CMPE2750/davidm_embedded/CMPE2750.kicad_pcb

## KiCad design CMPE2750.kicad_pcb (2024-11-19)

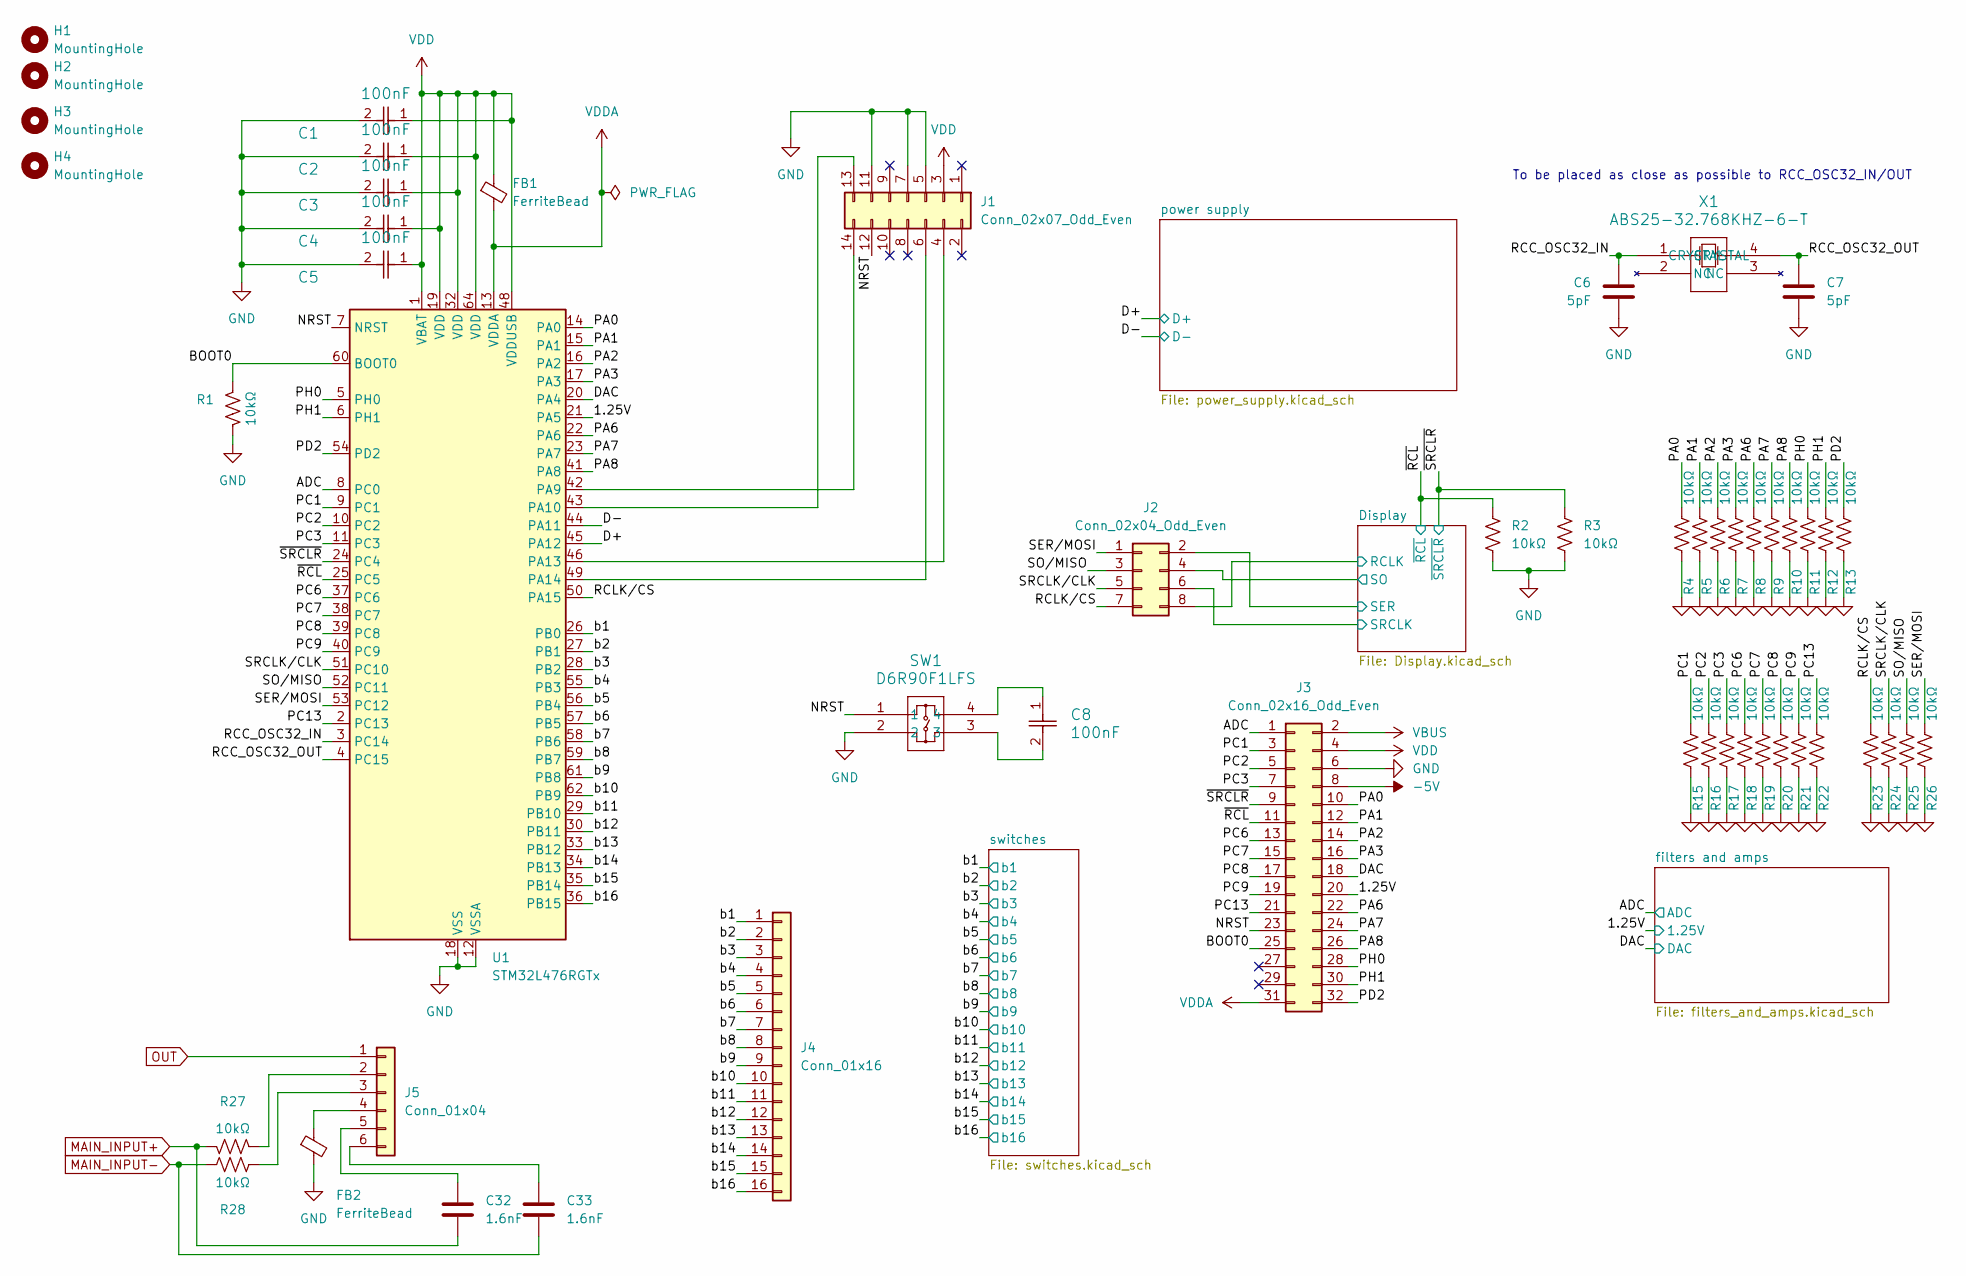
[picture p1: schematic CMPE2750.kicad_sch]

Parts:
C1, C2, C3, C4, C5, C8: 100nF; C_0402_1005Metric
C6, C7: 5pF; C_0402_1005Metric
C32, C33: 1.6nF; C_0805_2012Metric
FB1, FB2: FerriteBead; L_0603_1608Metric
H1, H2, H3, H4: MountingHole; MountingHole_3.2mm_M3
J1: Conn_02x07_Odd_Even; CONN_FTSH-107-01-F-DV-K-P-TR_SAI
J2: Conn_02x04_Odd_Even; PinHeader_2x04_P2.54mm_Vertical
J3: Conn_02x16_Odd_Even; PinHeader_2x16_P2.54mm_Vertical
J4: Conn_01x16; PinHeader_1x16_P2.54mm_Vertical
J5: Conn_01x04; PinHeader_1x06_P2.54mm_Vertical
R1, R2, R3, R4, R5, R6, R7, R8, R9, R10, R11, R12, R13, R15, R16, R17, R18, R19, R20, R21, R22, R23, R24, R25, R26, R27, R28: 10kΩ; R_0402_1005Metric
SW1: D6R90F1LFS; D6R_CNK
U1: STM32L476RGTx; LQFP-64_10x10mm_P0.5mm
X1: ABS25-32.768KHZ-6-T; X_ABS25_ABR

Connections:
-5V: J3.8; also elsewhere on the board
/1.25V: J3.20, U1.21 (PA5); also elsewhere on the board
/ADC: J3.1, U1.8 (PC0); also elsewhere on the board
/BOOT0: J3.25, R1.1, U1.60 (BOOT0)
/D+: U1.45 (PA12); also elsewhere on the board
/D-: U1.44 (PA11); also elsewhere on the board
/DAC: J3.18, U1.20 (PA4); also elsewhere on the board
/Display/RCLK: J2.8; also elsewhere on the board
/Display/SER: J2.2; also elsewhere on the board
/Display/SO: J2.4; also elsewhere on the board
/Display/SRCLK: J2.6; also elsewhere on the board
/NRST: J1.12, J3.23, SW1.1, U1.7 (NRST)
/PA0: J3.10, R4.1, U1.14 (PA0)
/PA1: J3.12, R5.1, U1.15 (PA1)
/PA2: J3.14, R6.1, U1.16 (PA2)
/PA3: J3.16, R7.1, U1.17 (PA3)
/PA6: J3.22, R8.1, U1.22 (PA6)
/PA7: J3.24, R9.1, U1.23 (PA7)
/PA8: J3.26, R10.1, U1.41 (PA8)
/PC1: J3.3, R15.1, U1.9 (PC1)
/PC2: J3.5, R16.1, U1.10 (PC2)
/PC3: J3.7, R17.1, U1.11 (PC3)
/PC6: J3.13, R18.1, U1.37 (PC6)
/PC7: J3.15, R19.1, U1.38 (PC7)
/PC8: J3.17, R20.1, U1.39 (PC8)
/PC9: J3.19, R21.1, U1.40 (PC9)
/PC13: J3.21, R22.1, U1.2 (PC13)
/PD2: J3.32, R13.1, U1.54 (PD2)
/PH0: J3.28, R11.1, U1.5 (PH0)
/PH1: J3.30, R12.1, U1.6 (PH1)
/RCC_OSC32_IN: C6.1, U1.3 (PC14), X1.1 (CRYSTAL)
/RCC_OSC32_OUT: C7.1, U1.4 (PC15), X1.4 (CRYSTAL)
/RCLK/CS: J2.7, R23.1, U1.50 (PA15)
/SER/MOSI: J2.1, R26.1, U1.53 (PC12)
/SO/MISO: J2.3, R25.1, U1.52 (PC11)
/SRCLK/CLK: J2.5, R24.1, U1.51 (PC10)
/b1: J4.1, U1.26 (PB0); also elsewhere on the board
/b2: J4.2, U1.27 (PB1); also elsewhere on the board
/b3: J4.3, U1.28 (PB2); also elsewhere on the board
/b4: J4.4, U1.55 (PB3); also elsewhere on the board
/b5: J4.5, U1.56 (PB4); also elsewhere on the board
/b6: J4.6, U1.57 (PB5); also elsewhere on the board
/b7: J4.7, U1.58 (PB6); also elsewhere on the board
/b8: J4.8, U1.59 (PB7); also elsewhere on the board
/b9: J4.9, U1.61 (PB8); also elsewhere on the board
/b10: J4.10, U1.62 (PB9); also elsewhere on the board
/b11: J4.11, U1.29 (PB10); also elsewhere on the board
/b12: J4.12, U1.30 (PB11); also elsewhere on the board
/b13: J4.13, U1.33 (PB12); also elsewhere on the board
/b14: J4.14, U1.34 (PB13); also elsewhere on the board
/b15: J4.15, U1.35 (PB14); also elsewhere on the board
/b16: J4.16, U1.36 (PB15); also elsewhere on the board
/~RCL: J3.11, R2.1, U1.25 (PC5); also elsewhere on the board
/~SRCLR: J3.9, R3.1, U1.24 (PC4); also elsewhere on the board
GND: C1.2, C2.2, C3.2, C4.2, C5.2, C6.2, C7.2, FB2.2, J1.5, J1.7, J1.11, J3.6, R1.2, R2.2, R3.2, R4.2, R5.2, R6.2, R7.2, R8.2, R9.2, R10.2, R11.2, R12.2, R13.2, R15.2, R16.2, R17.2, R18.2, R19.2, R20.2, R21.2, R22.2, R23.2, R24.2, R25.2, R26.2, SW1.2, U1.12 (VSSA), U1.18 (VSS), U1.31 (VSS), U1.47 (VSS), U1.63 (VSS); also elsewhere on the board
MAIN_INPUT+: C32.1, R27.1; also elsewhere on the board
MAIN_INPUT-: C33.1, R28.1; also elsewhere on the board
unnamed: C8.1, SW1.4
unnamed: C8.2, SW1.3
unnamed: J1.4, U1.46 (PA13)
unnamed: J1.6, U1.49 (PA14)
unnamed: J1.13, U1.43 (PA10)
unnamed: J1.14, U1.42 (PA9)
unnamed: J5.2, R27.2
unnamed: J5.3, R28.2
unnamed: FB2.1, J5.4
unnamed: C32.2, J5.5
unnamed: C33.2, J5.6
OUT: J5.1; also elsewhere on the board
VBUS: J3.2; also elsewhere on the board
VDD: C1.1, C2.1, C3.1, C4.1, C5.1, FB1.1, J1.3, J3.4, U1.1 (VBAT), U1.19 (VDD), U1.32 (VDD), U1.48 (VDDUSB), U1.64 (VDD); also elsewhere on the board
VDDA: FB1.2, J3.31, U1.13 (VDDA)

Notes on the sheet:
To be placed as close as possible to RCC_OSC32_IN/OUT

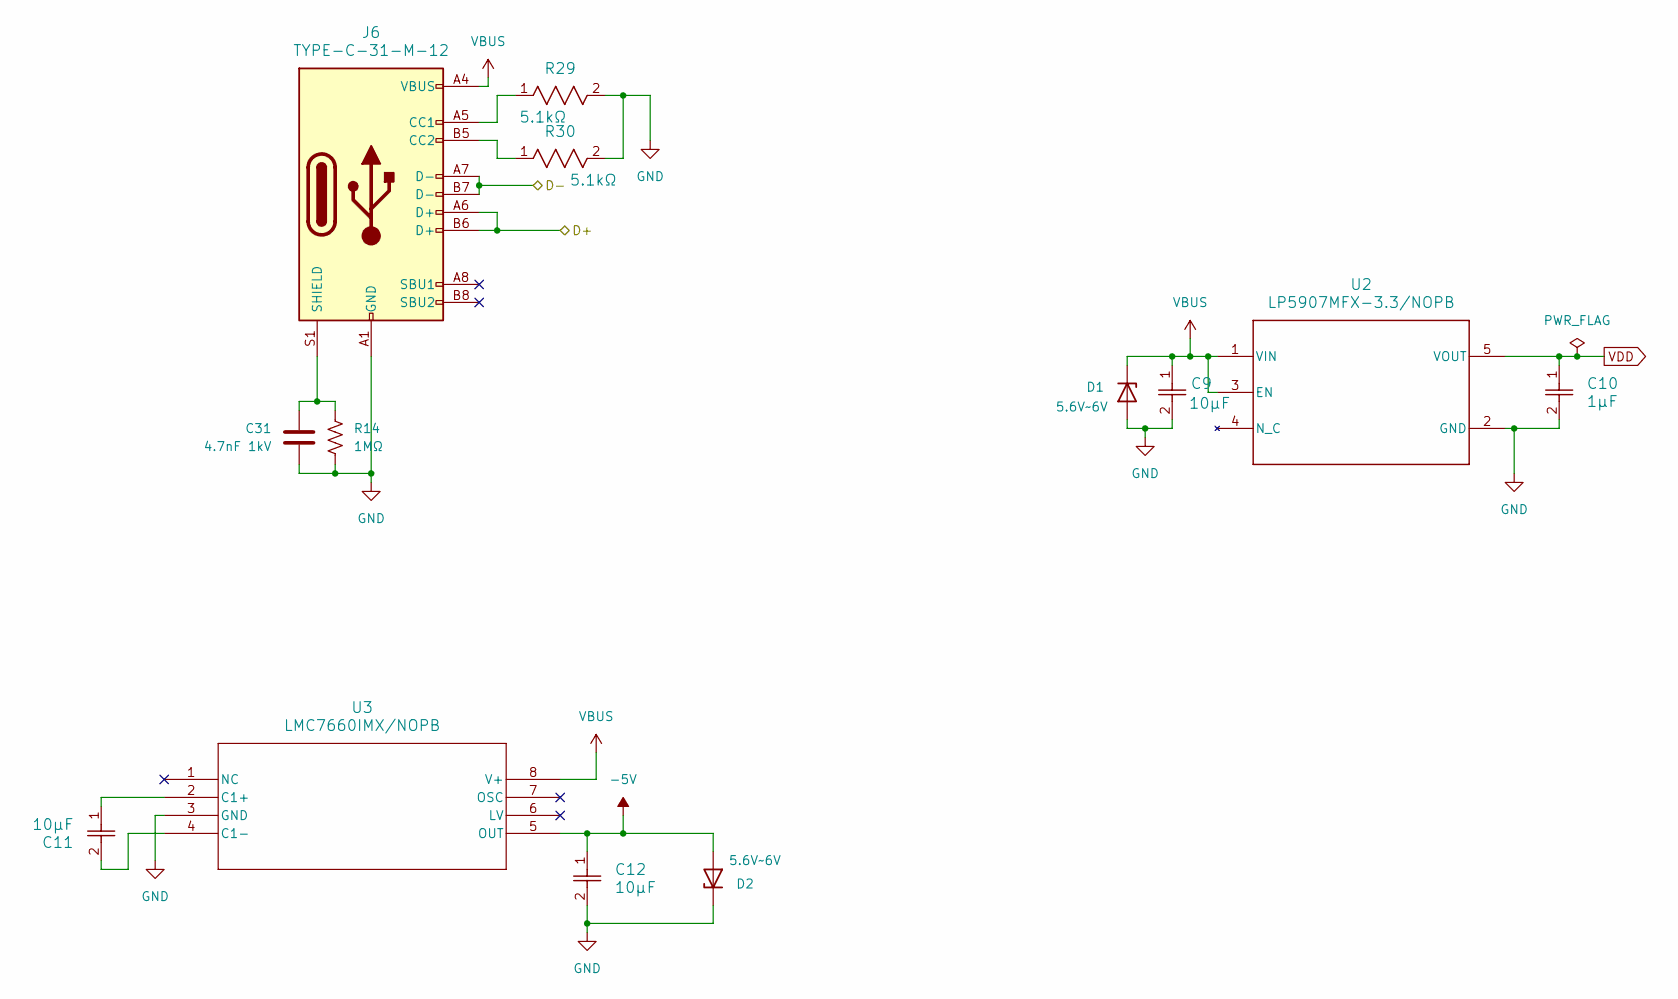
[picture p2: schematic power_supply.kicad_sch]

Parts:
C9, C11, C12: 10µF; C_1206_3216Metric
C10: 1µF; C_1206_3216Metric
C31: 4.7nF 1kV; C_1206_3216Metric
D1, D2: 5.6V~6V; D_SOD-123
J6: TYPE-C-31-M-12; USB_C_Receptacle_HRO_TYPE-C-31-M-12
R14: 1MΩ; R_2512_6332Metric
R29, R30: 5.1kΩ; R_0603_1608Metric
U2: LP5907MFX-3.3/NOPB; DBV0005A_N
U3: LMC7660IMX/NOPB; SOIC-8_3.9x4.9mm_P1.27mm

Connections:
-5V: C12.1, D2.2 (A), U3.5 (OUT); also elsewhere on the board
/D+: J6.A6 (D+), J6.B6 (D+); also elsewhere on the board
/D-: J6.A7 (D-), J6.B7 (D-); also elsewhere on the board
GND: C9.2, C10.2, C12.2, C31.2, D1.2 (A), D2.1 (K), J6.A1 (GND), J6.A12 (GND), J6.B1 (GND), J6.B12 (GND), R14.2, R29.2, R30.2, U2.2 (GND), U3.3 (GND); also elsewhere on the board
unnamed: J6.A5 (CC1), R29.1
unnamed: J6.B5 (CC2), R30.1
unnamed: C31.1, J6.S1 (SHIELD), R14.1
unnamed: C11.1, U3.2 (C1+)
unnamed: C11.2, U3.4 (C1-)
VBUS: C9.1, D1.1 (K), J6.A4 (VBUS), J6.A9 (VBUS), J6.B4 (VBUS), J6.B9 (VBUS), U2.1 (VIN), U2.3 (EN), U3.8 (V+); also elsewhere on the board
VDD: C10.1, U2.5 (VOUT); also elsewhere on the board

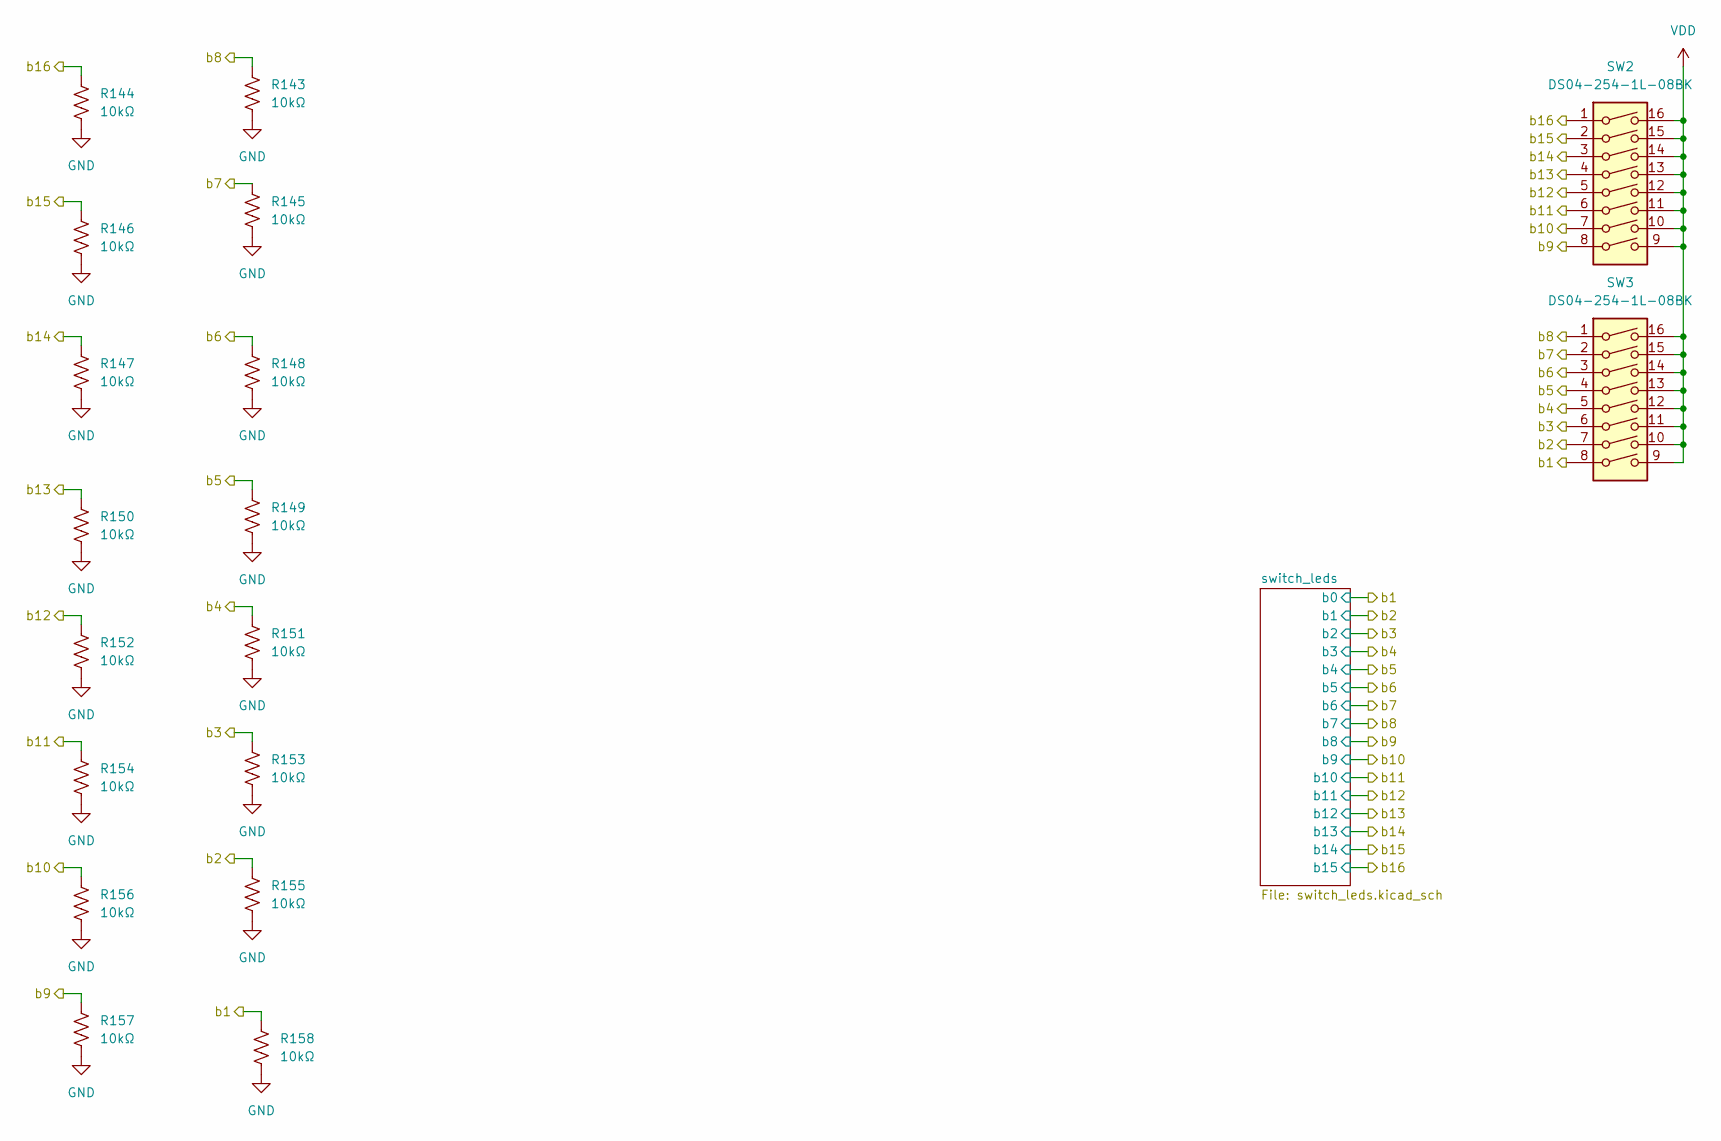
[picture p3: schematic switches.kicad_sch]

Parts:
R143, R144, R145, R146, R147, R148, R149, R150, R151, R152, R153, R154, R155, R156, R157, R158: 10kΩ; R_0402_1005Metric
SW2, SW3: DS04-254-1L-08BK; DIP-16_W7.62mm

Connections:
/b1: R158.1, SW3.8; also elsewhere on the board
/b2: R155.1, SW3.7; also elsewhere on the board
/b3: R153.1, SW3.6; also elsewhere on the board
/b4: R151.1, SW3.5; also elsewhere on the board
/b5: R149.1, SW3.4; also elsewhere on the board
/b6: R148.1, SW3.3; also elsewhere on the board
/b7: R145.1, SW3.2; also elsewhere on the board
/b8: R143.1, SW3.1; also elsewhere on the board
/b9: R157.1, SW2.8; also elsewhere on the board
/b10: R156.1, SW2.7; also elsewhere on the board
/b11: R154.1, SW2.6; also elsewhere on the board
/b12: R152.1, SW2.5; also elsewhere on the board
/b13: R150.1, SW2.4; also elsewhere on the board
/b14: R147.1, SW2.3; also elsewhere on the board
/b15: R146.1, SW2.2; also elsewhere on the board
/b16: R144.1, SW2.1; also elsewhere on the board
GND: R143.2, R144.2, R145.2, R146.2, R147.2, R148.2, R149.2, R150.2, R151.2, R152.2, R153.2, R154.2, R155.2, R156.2, R157.2, R158.2; also elsewhere on the board
VDD: SW2.9, SW2.10, SW2.11, SW2.12, SW2.13, SW2.14, SW2.15, SW2.16, SW3.9, SW3.10, SW3.11, SW3.12, SW3.13, SW3.14, SW3.15, SW3.16; also elsewhere on the board

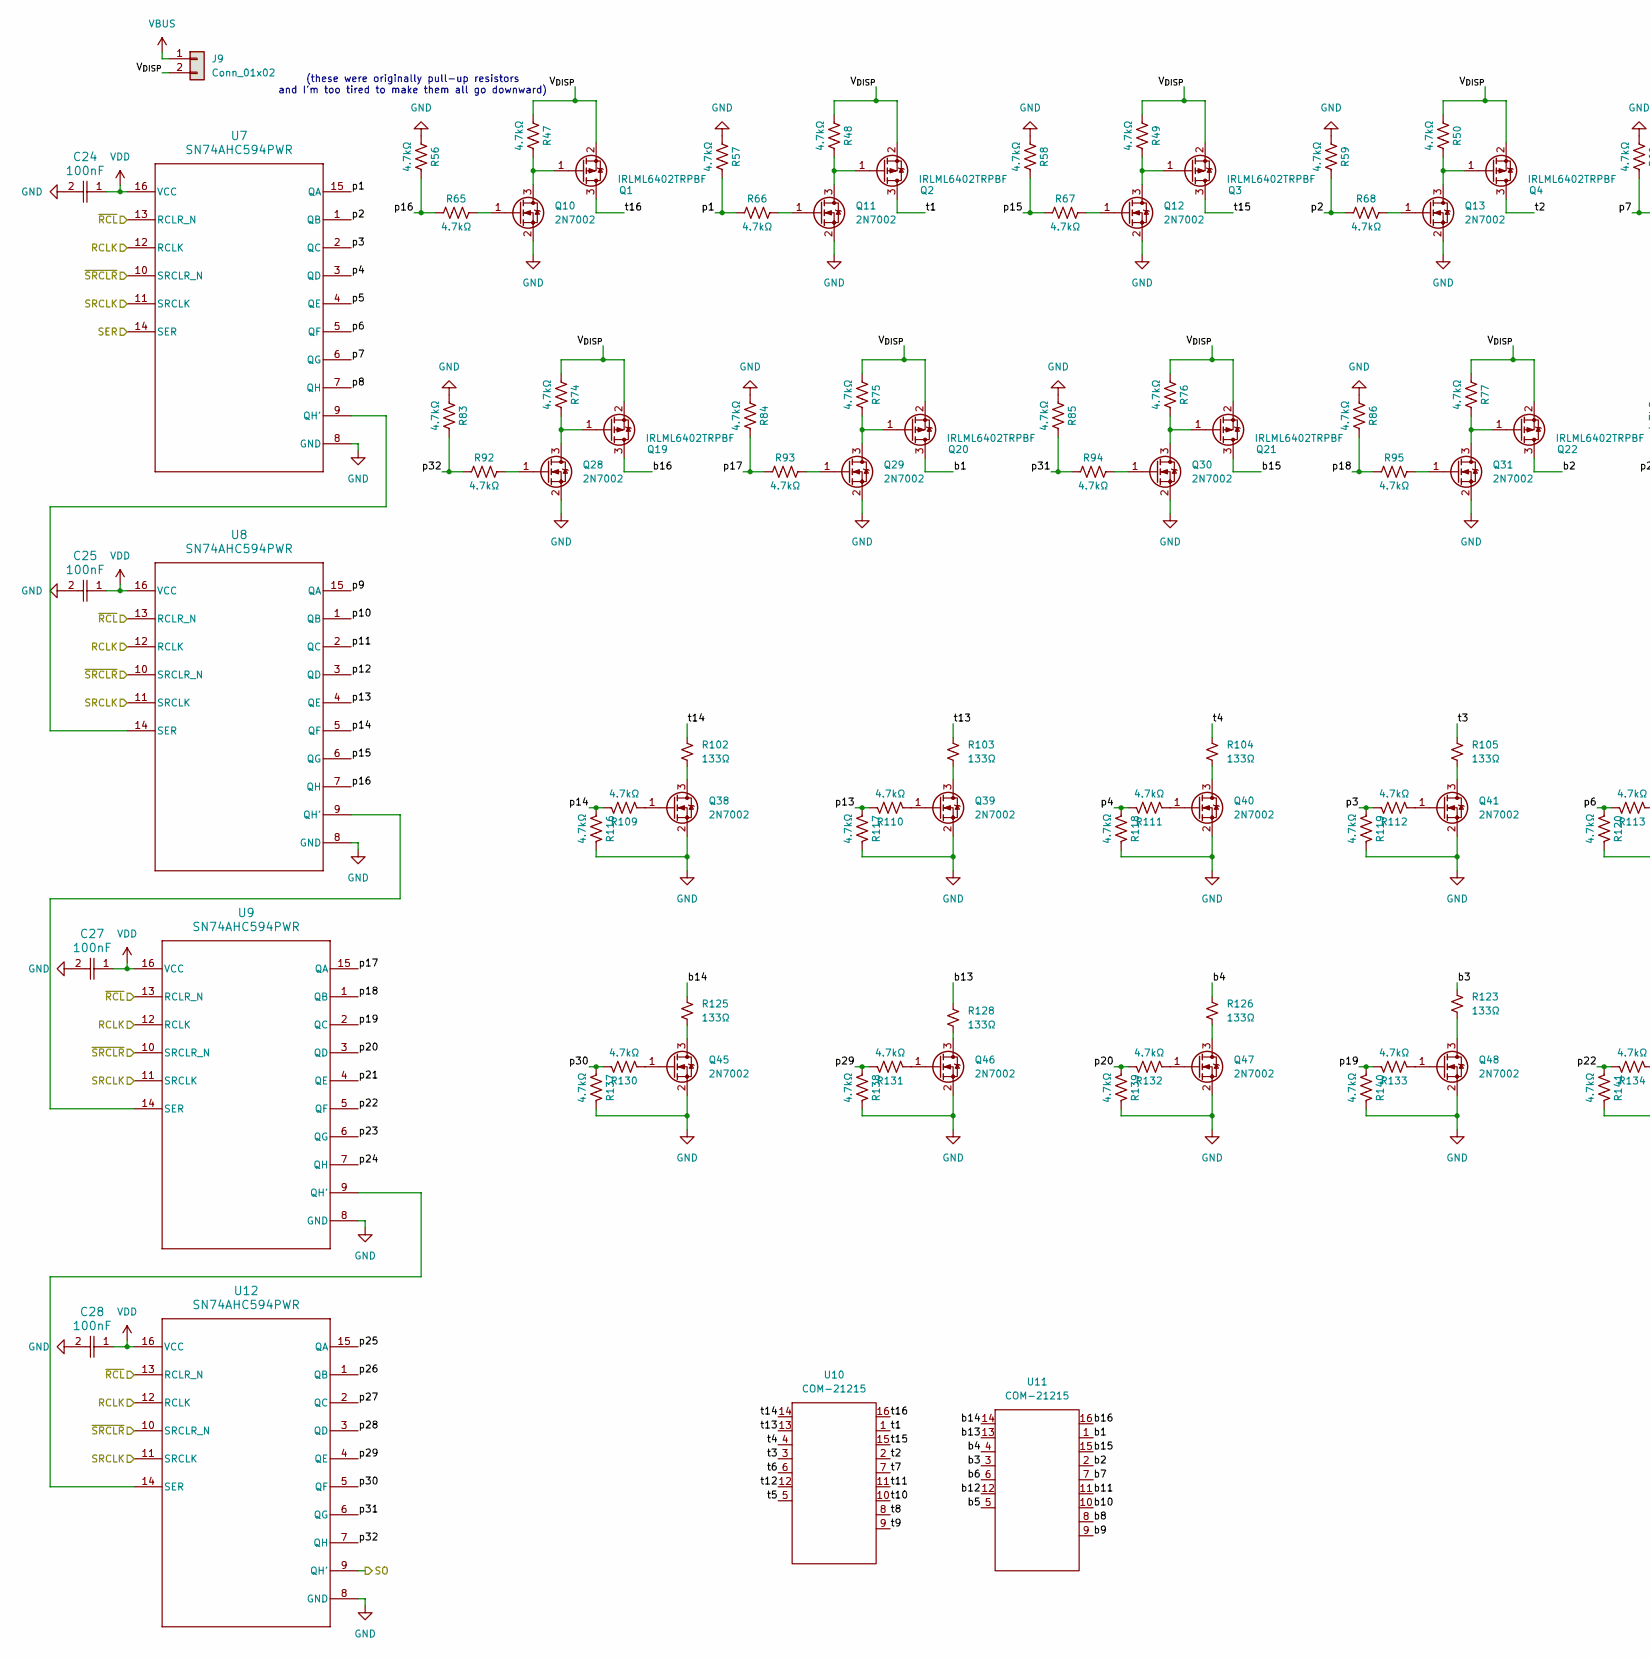
[picture p4: schematic Display.kicad_sch, part in row 1, column 1]

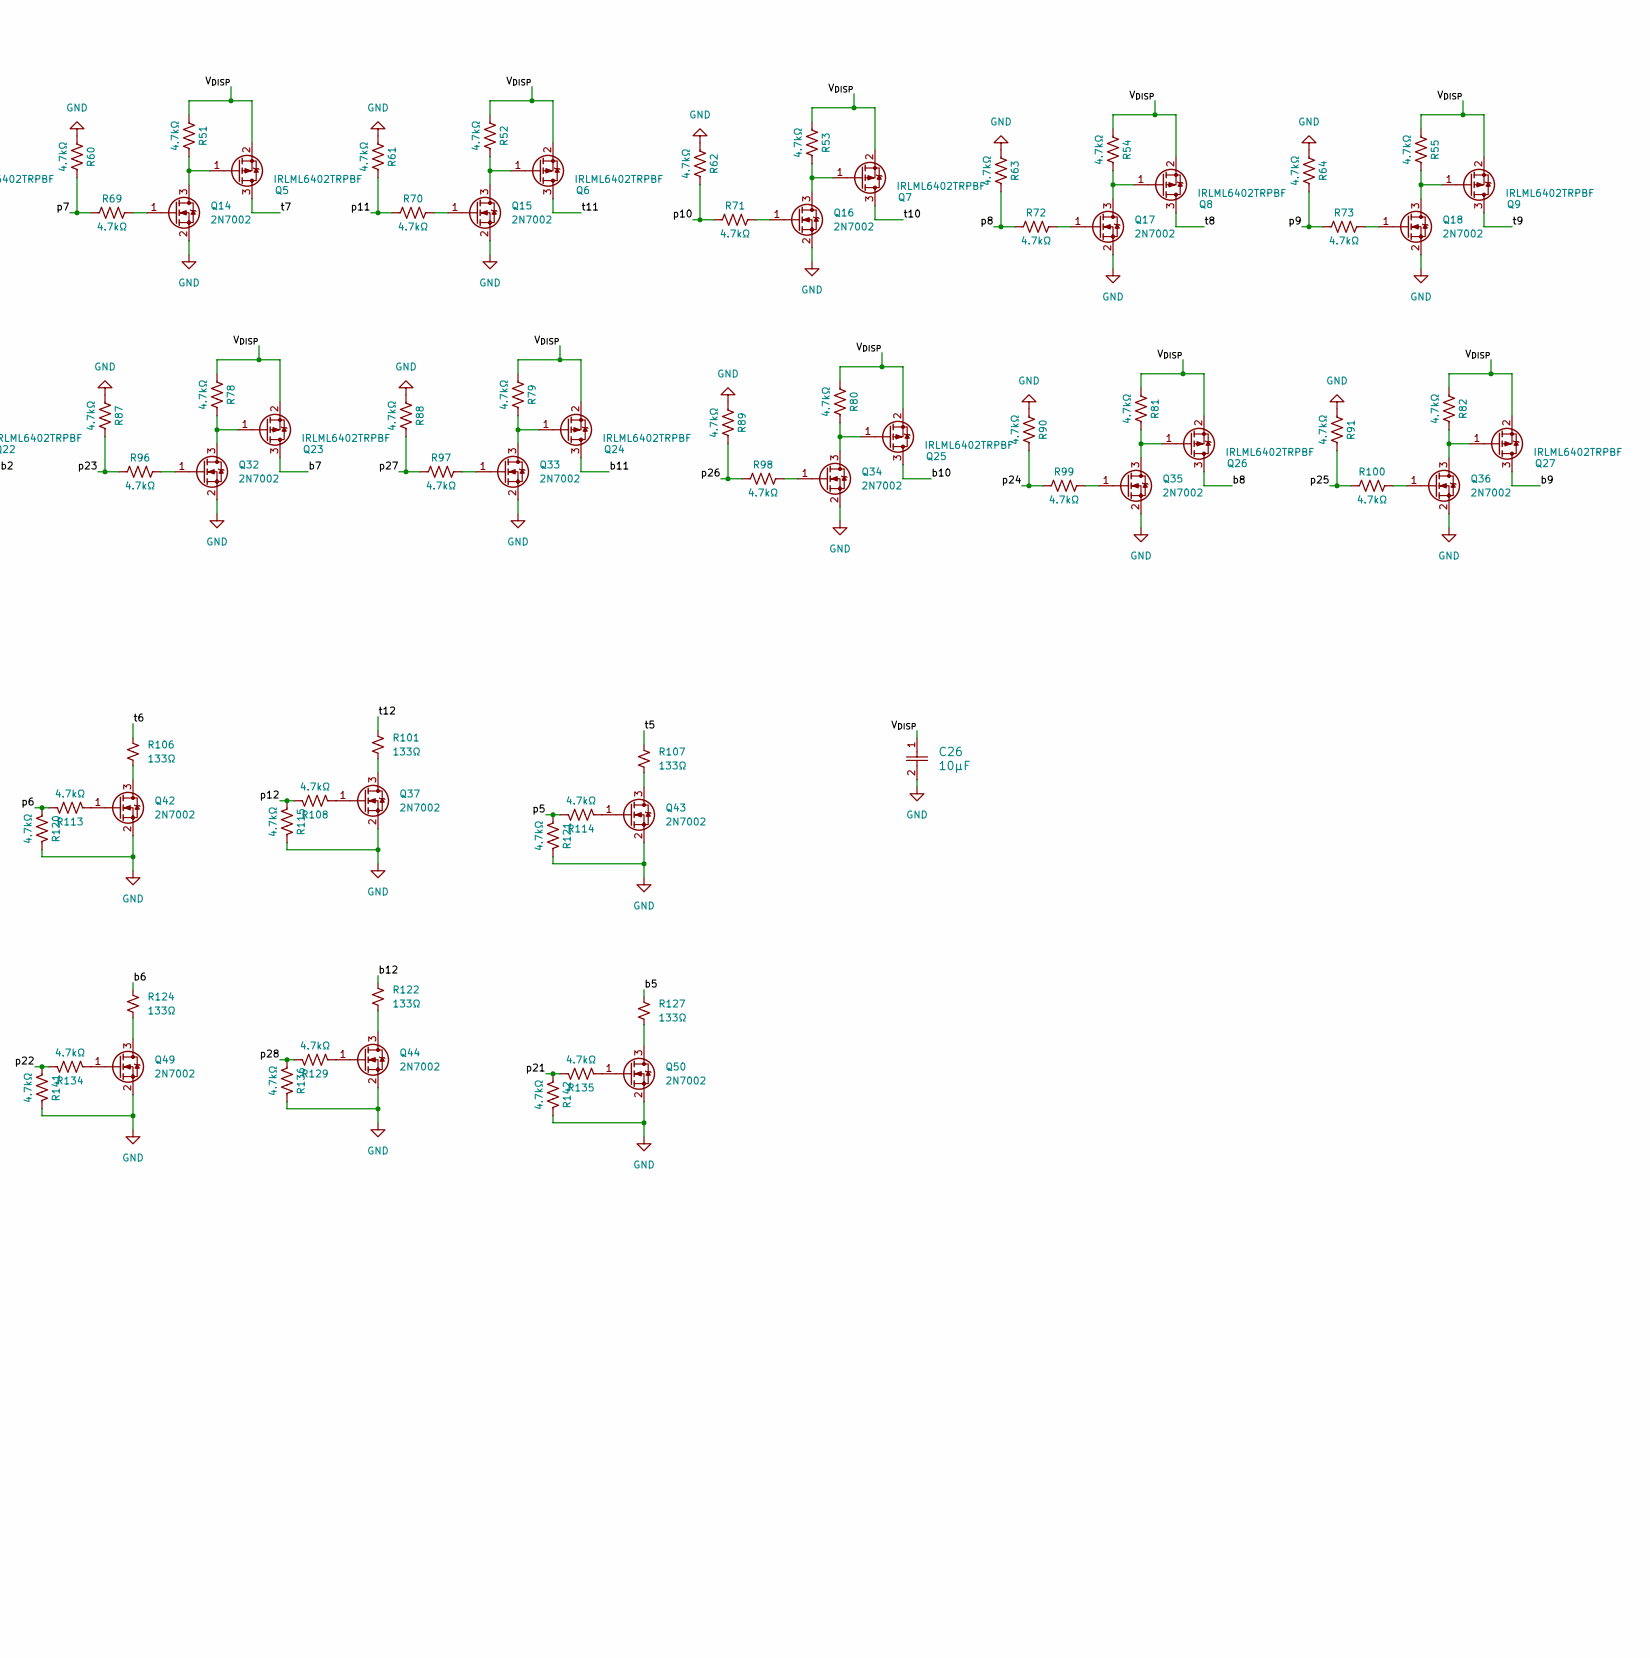
[picture p5: schematic Display.kicad_sch, part in row 1, column 2]

Parts:
C24, C25, C27, C28: 100nF; C_0402_1005Metric
C26: 10µF; C_1206_3216Metric
J9: Conn_01x02; PinHeader_1x02_P2.54mm_Vertical
Q1, Q2, Q3, Q4, Q5, Q6, Q7, Q8, Q9, Q19, Q20, Q21, Q22, Q23, Q24, Q25, Q26, Q27: IRLML6402TRPBF; SOT-23
Q10, Q11, Q12, Q13, Q14, Q15, Q16, Q17, Q18, Q28, Q29, Q30, Q31, Q32, Q33, Q34, Q35, Q36, Q37, Q38, Q39, Q40, Q41, Q42, Q43, Q44, Q45, Q46, Q47, Q48, Q49, Q50: 2N7002; SOT-23
R47, R48, R49, R50, R51, R52, R53, R54, R55, R56, R57, R58, R59, R60, R61, R62, R63, R64, R65, R66, R67, R68, R69, R70, R71, R72, R73, R74, R75, R76, R77, R78, R79, R80, R81, R82, R83, R84, R85, R86, R87, R88, R89, R90, R91, R92, R93, R94, R95, R96, R97, R98, R99, R100, R108, R109, R110, R111, R112, R113, R114, R115, R116, R117, R118, R119, R120, R121, R129, R130, R131, R132, R133, R134, R135, R136, R137, R138, R139, R140, R141, R142: 4.7kΩ; R_0402_1005Metric
R101, R102, R103, R104, R105, R106, R107, R122, R123, R124, R125, R126, R127, R128: 133Ω; R_0603_1608Metric
U7, U8, U9, U12: SN74AHC594PWR; TSSOP-16_4.4x5mm_P0.65mm
U10, U11: COM-21215

Connections:
/Display/RCLK: U7.12 (RCLK), U8.12 (RCLK), U9.12 (RCLK), U12.12 (RCLK); also elsewhere on the board
/Display/SER: U7.14 (SER); also elsewhere on the board
/Display/SO: U12.9 (QH'); also elsewhere on the board
/Display/SRCLK: U7.11 (SRCLK), U8.11 (SRCLK), U9.11 (SRCLK), U12.11 (SRCLK); also elsewhere on the board
/Display/V_{DISP}: C26.1, J9.2, Q1.2 (S), Q2.2 (S), Q3.2 (S), Q4.2 (S), Q5.2 (S), Q6.2 (S), Q7.2 (S), Q8.2 (S), Q9.2 (S), Q19.2 (S), Q20.2 (S), Q21.2 (S), Q22.2 (S), Q23.2 (S), Q24.2 (S), Q25.2 (S), Q26.2 (S), Q27.2 (S), R47.1, R48.1, R49.1, R50.1, R51.1, R52.1, R53.1, R54.1, R55.1, R74.1, R75.1, R76.1, R77.1, R78.1, R79.1, R80.1, R81.1, R82.1
/Display/b1: Q20.3 (D), U11.1
/Display/b2: Q22.3 (D), U11.2
/Display/b3: R123.1, U11.3
/Display/b4: R126.1, U11.4
/Display/b5: R127.1, U11.5
/Display/b6: R124.1, U11.6
/Display/b7: Q23.3 (D), U11.7
/Display/b8: Q26.3 (D), U11.8
/Display/b9: Q27.3 (D), U11.9
/Display/b10: Q25.3 (D), U11.10
/Display/b11: Q24.3 (D), U11.11
/Display/b12: R122.1, U11.12
/Display/b13: R128.1, U11.13
/Display/b14: R125.1, U11.14
/Display/b15: Q21.3 (D), U11.15
/Display/b16: Q19.3 (D), U11.16
/Display/p1: R57.2, R66.1, U7.15 (QA)
/Display/p2: R59.2, R68.1, U7.1 (QB)
/Display/p3: R112.1, R119.2, U7.2 (QC)
/Display/p4: R111.1, R118.2, U7.3 (QD)
/Display/p5: R114.1, R121.2, U7.4 (QE)
/Display/p6: R113.1, R120.2, U7.5 (QF)
/Display/p7: R60.2, R69.1, U7.6 (QG)
/Display/p8: R63.2, R72.1, U7.7 (QH)
/Display/p9: R64.2, R73.1, U8.15 (QA)
/Display/p10: R62.2, R71.1, U8.1 (QB)
/Display/p11: R61.2, R70.1, U8.2 (QC)
/Display/p12: R108.1, R115.2, U8.3 (QD)
/Display/p13: R110.1, R117.2, U8.4 (QE)
/Display/p14: R109.1, R116.2, U8.5 (QF)
/Display/p15: R58.2, R67.1, U8.6 (QG)
/Display/p16: R56.2, R65.1, U8.7 (QH)
/Display/p17: R84.2, R93.1, U9.15 (QA)
/Display/p18: R86.2, R95.1, U9.1 (QB)
/Display/p19: R133.1, R140.2, U9.2 (QC)
/Display/p20: R132.1, R139.2, U9.3 (QD)
/Display/p21: R135.1, R142.2, U9.4 (QE)
/Display/p22: R134.1, R141.2, U9.5 (QF)
/Display/p23: R87.2, R96.1, U9.6 (QG)
/Display/p24: R90.2, R99.1, U9.7 (QH)
/Display/p25: R91.2, R100.1, U12.15 (QA)
/Display/p26: R89.2, R98.1, U12.1 (QB)
/Display/p27: R88.2, R97.1, U12.2 (QC)
/Display/p28: R129.1, R136.2, U12.3 (QD)
/Display/p29: R131.1, R138.2, U12.4 (QE)
/Display/p30: R130.1, R137.2, U12.5 (QF)
/Display/p31: R85.2, R94.1, U12.6 (QG)
/Display/p32: R83.2, R92.1, U12.7 (QH)
/Display/t1: Q2.3 (D), U10.1
/Display/t2: Q4.3 (D), U10.2
/Display/t3: R105.1, U10.3
/Display/t4: R104.1, U10.4
/Display/t5: R107.1, U10.5
/Display/t6: R106.1, U10.6
/Display/t7: Q5.3 (D), U10.7
/Display/t8: Q8.3 (D), U10.8
/Display/t9: Q9.3 (D), U10.9
/Display/t10: Q7.3 (D), U10.10
/Display/t11: Q6.3 (D), U10.11
/Display/t12: R101.1, U10.12
/Display/t13: R103.1, U10.13
/Display/t14: R102.1, U10.14
/Display/t15: Q3.3 (D), U10.15
/Display/t16: Q1.3 (D), U10.16
/~RCL: U7.13 (RCLR_N), U8.13 (RCLR_N), U9.13 (RCLR_N), U12.13 (RCLR_N); also elsewhere on the board
/~SRCLR: U7.10 (SRCLR_N), U8.10 (SRCLR_N), U9.10 (SRCLR_N), U12.10 (SRCLR_N); also elsewhere on the board
GND: C24.2, C25.2, C26.2, C27.2, C28.2, Q10.2 (S), Q11.2 (S), Q12.2 (S), Q13.2 (S), Q14.2 (S), Q15.2 (S), Q16.2 (S), Q17.2 (S), Q18.2 (S), Q28.2 (S), Q29.2 (S), Q30.2 (S), Q31.2 (S), Q32.2 (S), Q33.2 (S), Q34.2 (S), Q35.2 (S), Q36.2 (S), Q37.2 (S), Q38.2 (S), Q39.2 (S), Q40.2 (S), Q41.2 (S), Q42.2 (S), Q43.2 (S), Q44.2 (S), Q45.2 (S), Q46.2 (S), Q47.2 (S), Q48.2 (S), Q49.2 (S), Q50.2 (S), R56.1, R57.1, R58.1, R59.1, R60.1, R61.1, R62.1, R63.1, R64.1, R83.1, R84.1, R85.1, R86.1, R87.1, R88.1, R89.1, R90.1, R91.1, R115.1, R116.1, R117.1, R118.1, R119.1, R120.1, R121.1, R136.1, R137.1, R138.1, R139.1, R140.1, R141.1, R142.1, U7.8 (GND), U8.8 (GND), U9.8 (GND), U12.8 (GND); also elsewhere on the board
unnamed: Q1.1 (G), Q10.3 (D), R47.2
unnamed: Q10.1 (G), R65.2
unnamed: Q2.1 (G), Q11.3 (D), R48.2
unnamed: Q11.1 (G), R66.2
unnamed: Q3.1 (G), Q12.3 (D), R49.2
unnamed: Q12.1 (G), R67.2
unnamed: Q4.1 (G), Q13.3 (D), R50.2
unnamed: Q13.1 (G), R68.2
unnamed: Q5.1 (G), Q14.3 (D), R51.2
unnamed: Q14.1 (G), R69.2
unnamed: Q6.1 (G), Q15.3 (D), R52.2
unnamed: Q15.1 (G), R70.2
unnamed: Q7.1 (G), Q16.3 (D), R53.2
unnamed: Q16.1 (G), R71.2
unnamed: Q8.1 (G), Q17.3 (D), R54.2
unnamed: Q17.1 (G), R72.2
unnamed: Q9.1 (G), Q18.3 (D), R55.2
unnamed: Q18.1 (G), R73.2
unnamed: Q19.1 (G), Q28.3 (D), R74.2
unnamed: Q20.1 (G), Q29.3 (D), R75.2
unnamed: Q21.1 (G), Q30.3 (D), R76.2
unnamed: Q22.1 (G), Q31.3 (D), R77.2
unnamed: Q23.1 (G), Q32.3 (D), R78.2
unnamed: Q24.1 (G), Q33.3 (D), R79.2
unnamed: Q25.1 (G), Q34.3 (D), R80.2
unnamed: Q26.1 (G), Q35.3 (D), R81.2
unnamed: Q27.1 (G), Q36.3 (D), R82.2
unnamed: Q28.1 (G), R92.2
unnamed: Q29.1 (G), R93.2
unnamed: Q30.1 (G), R94.2
unnamed: Q31.1 (G), R95.2
unnamed: Q32.1 (G), R96.2
unnamed: Q33.1 (G), R97.2
unnamed: Q34.1 (G), R98.2
unnamed: Q35.1 (G), R99.2
unnamed: Q36.1 (G), R100.2
unnamed: Q37.3 (D), R101.2
unnamed: Q37.1 (G), R108.2
unnamed: Q38.3 (D), R102.2
unnamed: Q38.1 (G), R109.2
unnamed: Q39.3 (D), R103.2
unnamed: Q39.1 (G), R110.2
unnamed: Q40.3 (D), R104.2
unnamed: Q40.1 (G), R111.2
unnamed: Q41.3 (D), R105.2
unnamed: Q41.1 (G), R112.2
unnamed: Q42.3 (D), R106.2
unnamed: Q42.1 (G), R113.2
unnamed: Q43.3 (D), R107.2
unnamed: Q43.1 (G), R114.2
unnamed: Q44.3 (D), R122.2
unnamed: Q44.1 (G), R129.2
unnamed: Q45.3 (D), R125.2
unnamed: Q45.1 (G), R130.2
unnamed: Q46.3 (D), R128.2
unnamed: Q46.1 (G), R131.2
unnamed: Q47.3 (D), R126.2
unnamed: Q47.1 (G), R132.2
unnamed: Q48.3 (D), R123.2
unnamed: Q48.1 (G), R133.2
unnamed: Q49.3 (D), R124.2
unnamed: Q49.1 (G), R134.2
unnamed: Q50.3 (D), R127.2
unnamed: Q50.1 (G), R135.2
unnamed: U7.9 (QH'), U8.14 (SER)
unnamed: U8.9 (QH'), U9.14 (SER)
unnamed: U9.9 (QH'), U12.14 (SER)
VBUS: J9.1; also elsewhere on the board
VDD: C24.1, C25.1, C27.1, C28.1, U7.16 (VCC), U8.16 (VCC), U9.16 (VCC), U12.16 (VCC); also elsewhere on the board

Notes on the sheet:
(these were originally pull-up resistors and I'm too tired to make them all go downward)
