CMPE2750/davidm_embedded/CMPE2750.kicad_pcb

## KiCad design CMPE2750.kicad_pcb (continued)

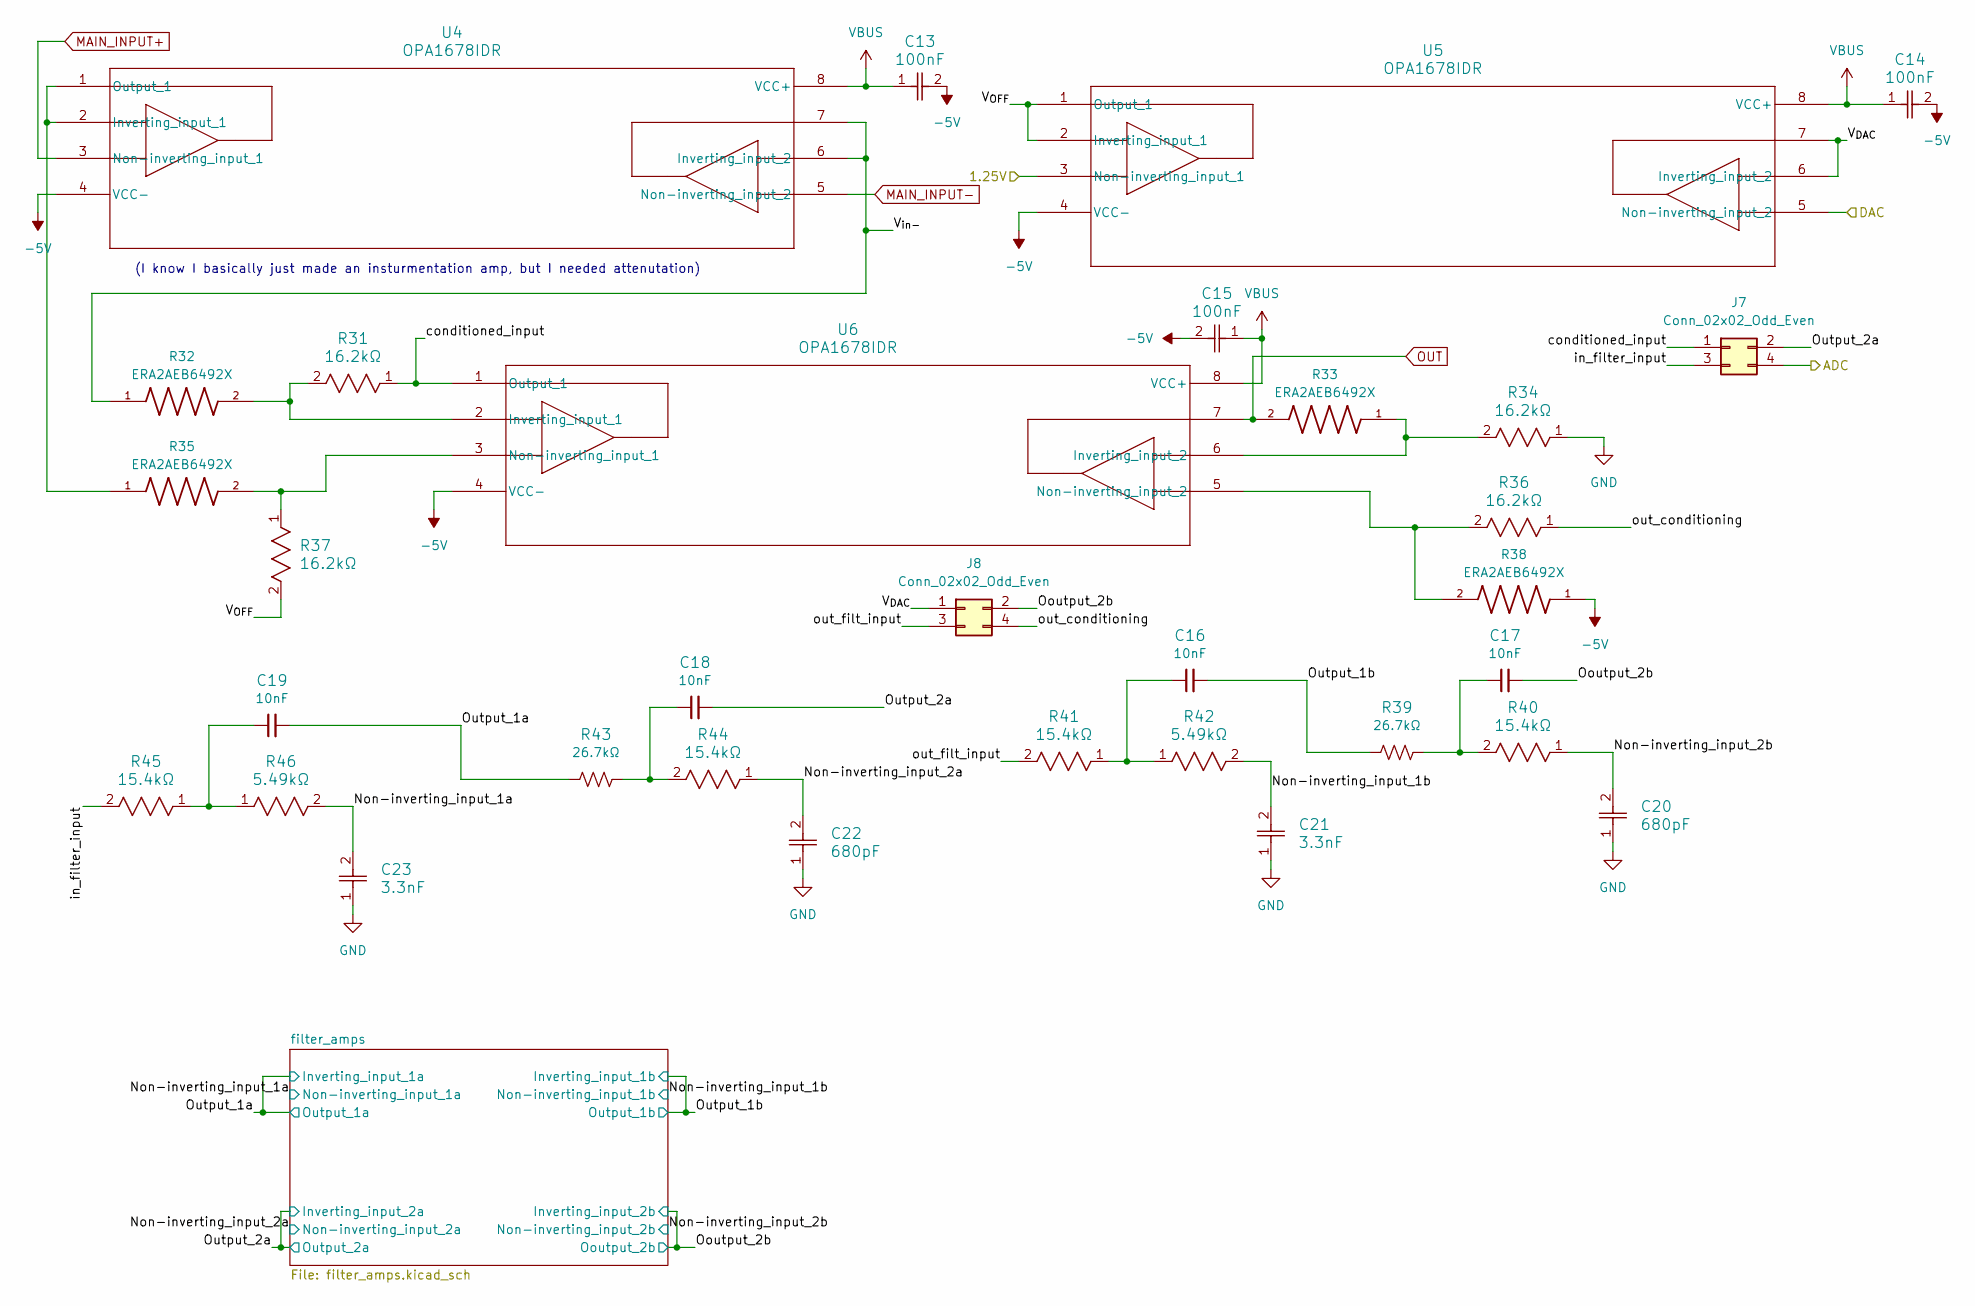
[picture p6: schematic filters_and_amps.kicad_sch]

Parts:
C13, C14, C15: 100nF; C_0402_1005Metric
C16, C17, C18, C19: 10nF; C_0805_2012Metric
C20, C22: 680pF; C_0402_1005Metric
C21, C23: 3.3nF; C_0603_1608Metric
J7, J8: Conn_02x02_Odd_Even; PinHeader_2x02_P2.54mm_Vertical
R31, R34, R36, R37: 16.2kΩ; R_0402_1005Metric
R32, R33, R35, R38: ERA2AEB6492X; R_0402_1005Metric; PARTREV 3/1/2020
R39, R43: 26.7kΩ; R_0603_1608Metric
R40, R41, R44, R45: 15.4kΩ; R_0603_1608Metric
R42, R46: 5.49kΩ; R_0402_1005Metric
U4, U5, U6: OPA1678IDR; SOIC-8_3.9x4.9mm_P1.27mm

Connections:
-5V: C13.2, C14.2, C15.2, R38.1, U4.4 (VCC-), U5.4 (VCC-), U6.4 (VCC-); also elsewhere on the board
/1.25V: U5.3 (Non-inverting_input_1); also elsewhere on the board
/ADC: J7.4; also elsewhere on the board
/DAC: U5.5 (Non-inverting_input_2); also elsewhere on the board
/filters and amps/Non-inverting_input_1a: C23.2, R46.2; also elsewhere on the board
/filters and amps/Non-inverting_input_1b: C21.2, R42.2; also elsewhere on the board
/filters and amps/Non-inverting_input_2a: C22.2, R44.1; also elsewhere on the board
/filters and amps/Non-inverting_input_2b: C20.2, R40.1; also elsewhere on the board
/filters and amps/Ooutput_2b: C17.2, J8.2; also elsewhere on the board
/filters and amps/Output_1a: C19.2, R43.1; also elsewhere on the board
/filters and amps/Output_1b: C16.2, R39.1; also elsewhere on the board
/filters and amps/Output_2a: C18.2, J7.2; also elsewhere on the board
/filters and amps/V_{DAC}: J8.1, U5.6 (Inverting_input_2), U5.7
/filters and amps/V_{OFF}: R37.2, U5.1 (Output_1), U5.2 (Inverting_input_1)
/filters and amps/V_{in-}: R32.1, U4.6 (Inverting_input_2), U4.7
/filters and amps/conditioned_input: J7.1, R31.1, U6.1 (Output_1)
/filters and amps/in_filter_input: J7.3, R45.2
/filters and amps/out_conditioning: J8.4, R36.1
/filters and amps/out_filt_input: J8.3, R41.2
GND: C20.1, C21.1, C22.1, C23.1, R34.1; also elsewhere on the board
MAIN_INPUT+: U4.3 (Non-inverting_input_1); also elsewhere on the board
MAIN_INPUT-: U4.5 (Non-inverting_input_2); also elsewhere on the board
unnamed: C16.1, R41.1, R42.1
unnamed: C17.1, R39.2, R40.2
unnamed: C18.1, R43.2, R44.2
unnamed: C19.1, R45.1, R46.1
unnamed: R35.1, U4.1 (Output_1), U4.2 (Inverting_input_1)
unnamed: R31.2, R32.2, U6.2 (Inverting_input_1)
unnamed: R33.1, R34.2, U6.6 (Inverting_input_2)
unnamed: R35.2, R37.1, U6.3 (Non-inverting_input_1)
unnamed: R36.2, R38.2, U6.5 (Non-inverting_input_2)
OUT: R33.2, U6.7; also elsewhere on the board
VBUS: C13.1, C14.1, C15.1, U4.8 (VCC+), U5.8 (VCC+), U6.8 (VCC+); also elsewhere on the board

Notes on the sheet:
(I know I basically just made an insturmentation amp, but I needed attenutation)

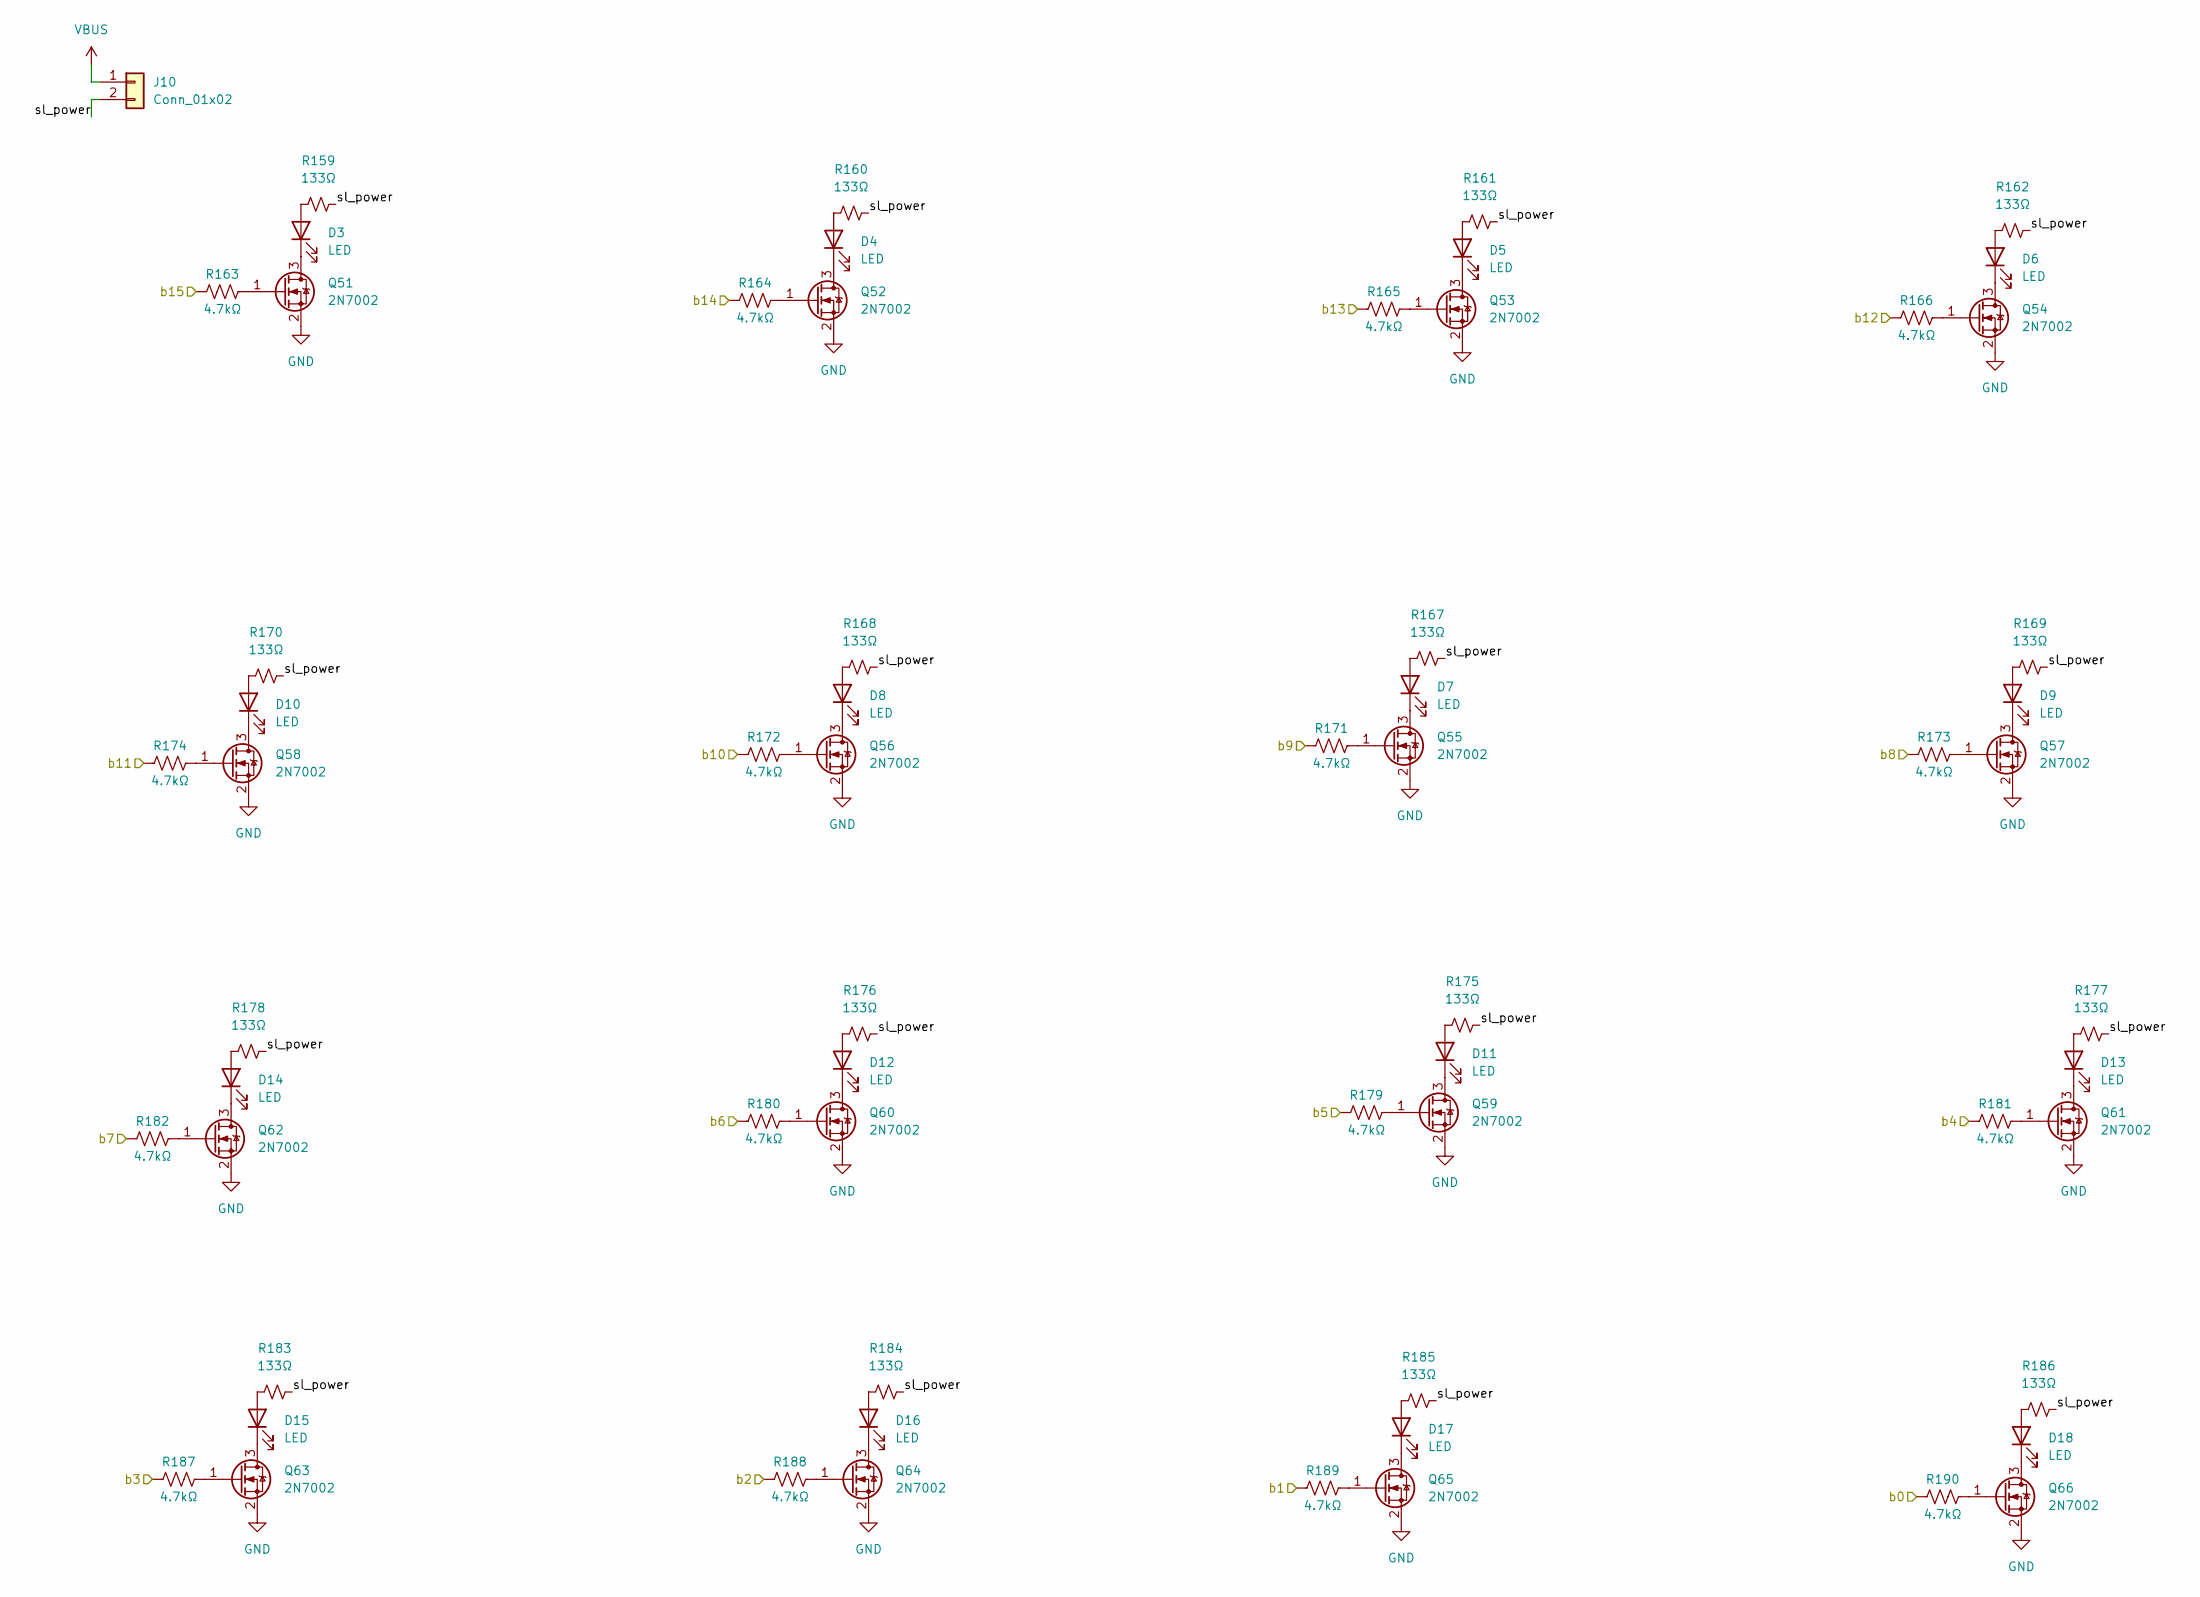
[picture p7: schematic switch_leds.kicad_sch]

Parts:
D3, D4, D5, D6, D7, D8, D9, D10, D11, D12, D13, D14, D15, D16, D17, D18: LED; LED_0805_2012Metric
J10: Conn_01x02; PinHeader_1x02_P2.54mm_Vertical
Q51, Q52, Q53, Q54, Q55, Q56, Q57, Q58, Q59, Q60, Q61, Q62, Q63, Q64, Q65, Q66: 2N7002; SOT-23
R159, R160, R161, R162, R167, R168, R169, R170, R175, R176, R177, R178, R183, R184, R185, R186: 133Ω; R_0603_1608Metric
R163, R164, R165, R166, R171, R172, R173, R174, R179, R180, R181, R182, R187, R188, R189, R190: 4.7kΩ; R_0402_1005Metric

Connections:
/b1: R190.1; also elsewhere on the board
/b2: R189.1; also elsewhere on the board
/b3: R188.1; also elsewhere on the board
/b4: R187.1; also elsewhere on the board
/b5: R181.1; also elsewhere on the board
/b6: R179.1; also elsewhere on the board
/b7: R180.1; also elsewhere on the board
/b8: R182.1; also elsewhere on the board
/b9: R173.1; also elsewhere on the board
/b10: R171.1; also elsewhere on the board
/b11: R172.1; also elsewhere on the board
/b12: R174.1; also elsewhere on the board
/b13: R166.1; also elsewhere on the board
/b14: R165.1; also elsewhere on the board
/b15: R164.1; also elsewhere on the board
/b16: R163.1; also elsewhere on the board
/switches/switch_leds/sl_power: J10.2, R159.2, R160.2, R161.2, R162.2, R167.2, R168.2, R169.2, R170.2, R175.2, R176.2, R177.2, R178.2, R183.2, R184.2, R185.2, R186.2
GND: Q51.2 (S), Q52.2 (S), Q53.2 (S), Q54.2 (S), Q55.2 (S), Q56.2 (S), Q57.2 (S), Q58.2 (S), Q59.2 (S), Q60.2 (S), Q61.2 (S), Q62.2 (S), Q63.2 (S), Q64.2 (S), Q65.2 (S), Q66.2 (S); also elsewhere on the board
unnamed: D3.2 (A), R159.1
unnamed: D3.1 (K), Q51.3 (D)
unnamed: D4.2 (A), R160.1
unnamed: D4.1 (K), Q52.3 (D)
unnamed: D5.2 (A), R161.1
unnamed: D5.1 (K), Q53.3 (D)
unnamed: D6.2 (A), R162.1
unnamed: D6.1 (K), Q54.3 (D)
unnamed: D7.2 (A), R167.1
unnamed: D7.1 (K), Q55.3 (D)
unnamed: D8.2 (A), R168.1
unnamed: D8.1 (K), Q56.3 (D)
unnamed: D9.2 (A), R169.1
unnamed: D9.1 (K), Q57.3 (D)
unnamed: D10.2 (A), R170.1
unnamed: D10.1 (K), Q58.3 (D)
unnamed: D11.2 (A), R175.1
unnamed: D11.1 (K), Q59.3 (D)
unnamed: D12.2 (A), R176.1
unnamed: D12.1 (K), Q60.3 (D)
unnamed: D13.2 (A), R177.1
unnamed: D13.1 (K), Q61.3 (D)
unnamed: D14.2 (A), R178.1
unnamed: D14.1 (K), Q62.3 (D)
unnamed: D15.2 (A), R183.1
unnamed: D15.1 (K), Q63.3 (D)
unnamed: D16.2 (A), R184.1
unnamed: D16.1 (K), Q64.3 (D)
unnamed: D17.2 (A), R185.1
unnamed: D17.1 (K), Q65.3 (D)
unnamed: D18.2 (A), R186.1
unnamed: D18.1 (K), Q66.3 (D)
unnamed: Q51.1 (G), R163.2
unnamed: Q52.1 (G), R164.2
unnamed: Q53.1 (G), R165.2
unnamed: Q54.1 (G), R166.2
unnamed: Q55.1 (G), R171.2
unnamed: Q56.1 (G), R172.2
unnamed: Q57.1 (G), R173.2
unnamed: Q58.1 (G), R174.2
unnamed: Q59.1 (G), R179.2
unnamed: Q60.1 (G), R180.2
unnamed: Q61.1 (G), R181.2
unnamed: Q62.1 (G), R182.2
unnamed: Q63.1 (G), R187.2
unnamed: Q64.1 (G), R188.2
unnamed: Q65.1 (G), R189.2
unnamed: Q66.1 (G), R190.2
VBUS: J10.1; also elsewhere on the board

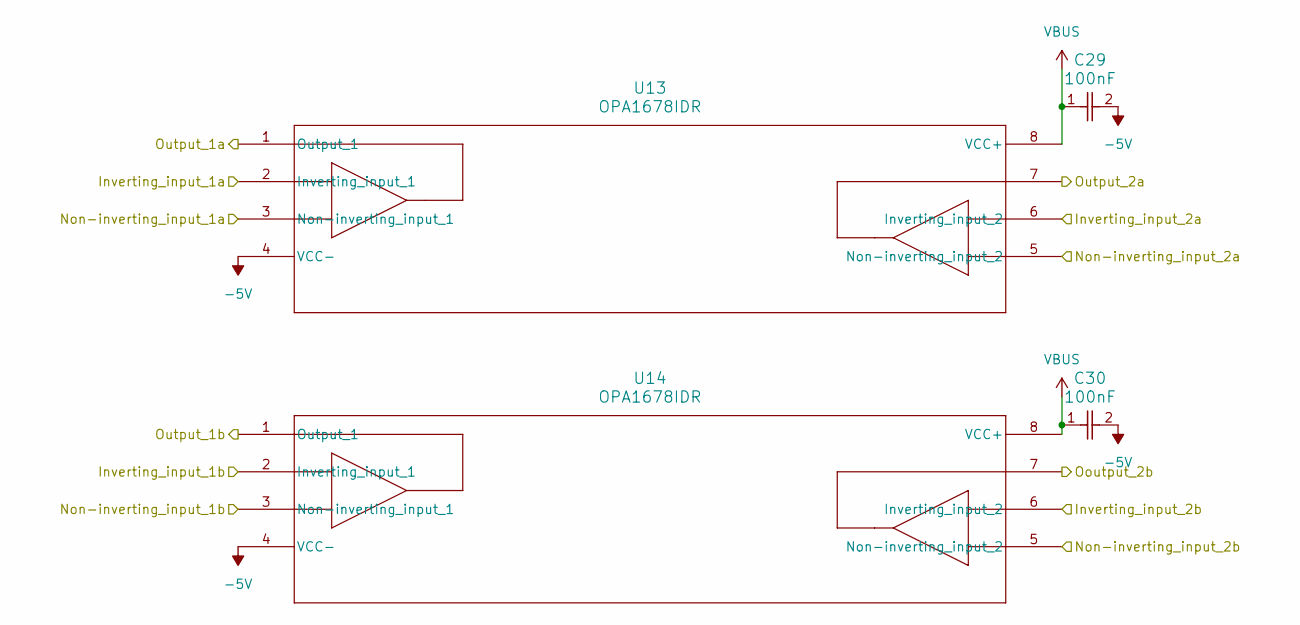
[picture p8: schematic filter_amps.kicad_sch]

Parts:
C29, C30: 100nF; C_0402_1005Metric
U13, U14: OPA1678IDR; SOIC-8_3.9x4.9mm_P1.27mm

Connections:
-5V: C29.2, C30.2, U13.4 (VCC-), U14.4 (VCC-); also elsewhere on the board
/filters and amps/Non-inverting_input_1a: U13.3 (Non-inverting_input_1); also elsewhere on the board
/filters and amps/Non-inverting_input_1b: U14.3 (Non-inverting_input_1); also elsewhere on the board
/filters and amps/Non-inverting_input_2a: U13.5 (Non-inverting_input_2); also elsewhere on the board
/filters and amps/Non-inverting_input_2b: U14.5 (Non-inverting_input_2); also elsewhere on the board
/filters and amps/Ooutput_2b: U14.6 (Inverting_input_2), U14.7; also elsewhere on the board
/filters and amps/Output_1a: U13.1 (Output_1), U13.2 (Inverting_input_1); also elsewhere on the board
/filters and amps/Output_1b: U14.1 (Output_1), U14.2 (Inverting_input_1); also elsewhere on the board
/filters and amps/Output_2a: U13.6 (Inverting_input_2), U13.7; also elsewhere on the board
VBUS: C29.1, C30.1, U13.8 (VCC+), U14.8 (VCC+); also elsewhere on the board

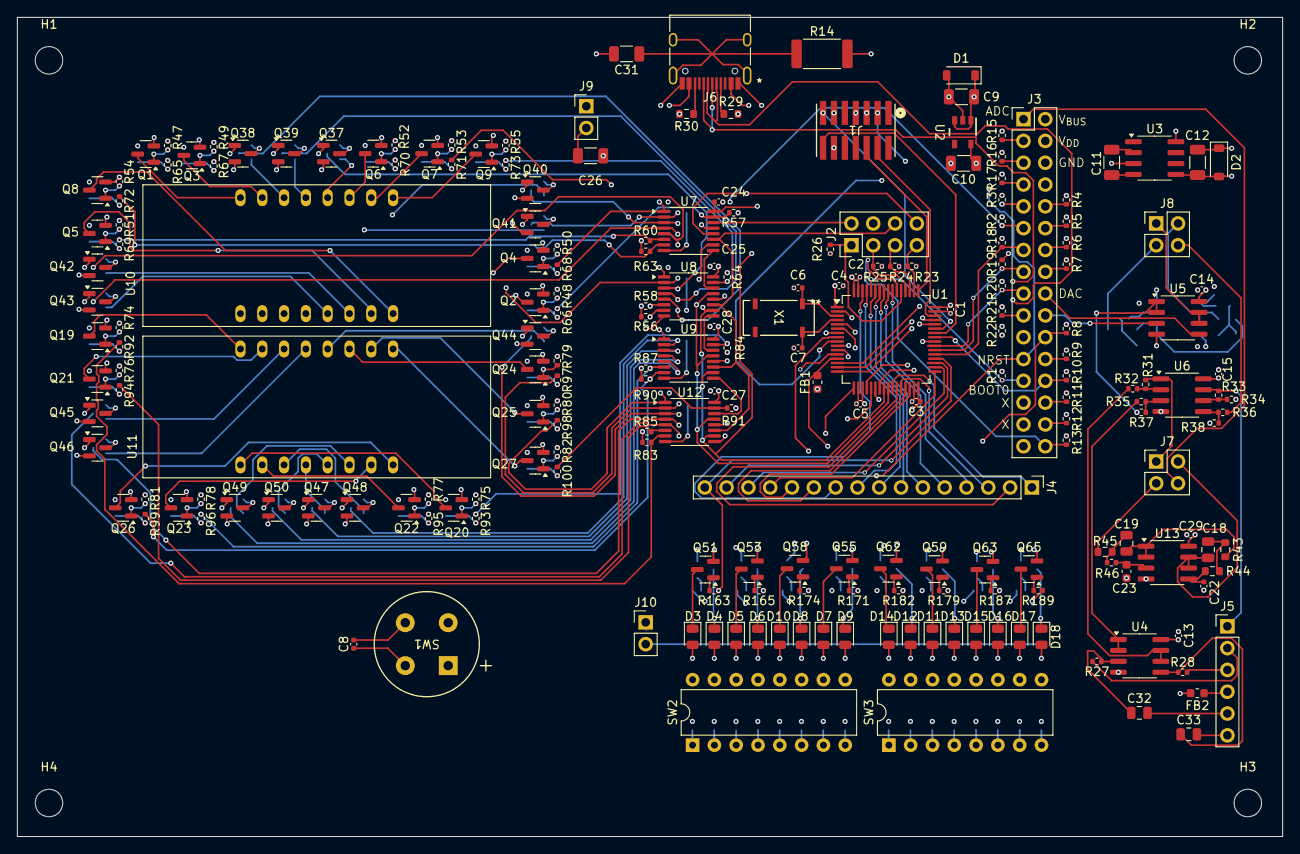
[picture p9: board CMPE2750.kicad_pcb from above]

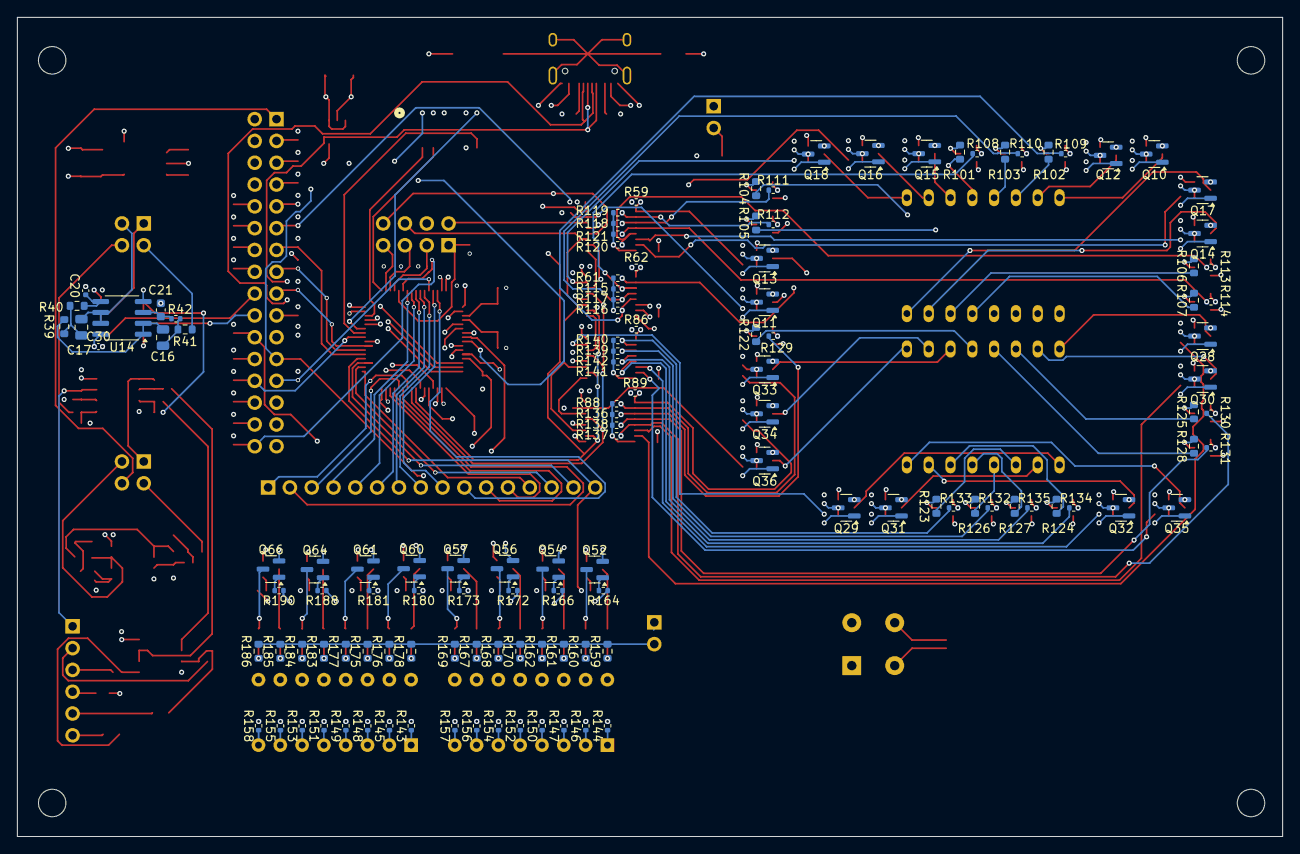
[picture p10: board CMPE2750.kicad_pcb from below]

Board: 6 copper layers, 147.4 x 95.4 mm, 341 parts (124 on the bottom side), 282 nets.
