CMPE2750/davidm_embedded/pinout_alt/pinout_alt.ioc

Mcu.UserName=STM32L476RGTx
PA0.Signal=S_TIM2_CH1
PA10.Signal=USART1_RX
PA11.Signal=USB_OTG_FS_DM
PA12.Signal=USB_OTG_FS_DP
PA2.Signal=RCC_LSCO
PA4.Signal=COMP_DAC11_group
PA5.Signal=COMP_DAC12_group
PA8.Signal=RCC_MCO
PA9.Signal=USART1_TX
PB0.Signal=GPIO_Input
PB1.Signal=GPIO_Input
PB10.Signal=GPIO_Input
PB11.Signal=GPIO_Input
PB12.Signal=GPIO_Input
PB13.Signal=GPIO_Input
PB14.Signal=GPIO_Input
PB15.Signal=GPIO_Input
PB2.Signal=GPIO_Input
PB5.Signal=GPIO_Input
PB6.Signal=GPIO_Input
PB7.Signal=GPIO_Input
PB8.Signal=GPIO_Input
PB9.Signal=GPIO_Input
PC0.Signal=ADCx_IN1
PC1.Signal=ADCx_IN2
PC10.GPIO_Label=SRCLK
PC10.Signal=GPIO_Output
PC11.GPIO_Label=SO
PC11.Signal=GPIO_Input
PC12.GPIO_Label=SER
PC12.Signal=GPIO_Output
PC4.GPIO_Label=SRCL_N
PC4.Signal=GPIO_Output
PC5.GPIO_Label=RCL_N
PC5.Signal=GPIO_Output
