CMPE2750/davidm_embedded/(commit log)

2024-11-08 First commit. Preparing to try a change
    [CMPE2750.kicad_pcb, CMPE2750.kicad_sch, Display.kicad_sch, current.kicad_sch, filters_and_amps.kicad_sch, kathodes.kicad_sch, power_supply.kicad_sch, switch_leds.kicad_sch]
2024-11-08 Changed how the 14-segment displays were controlled to just use a couple shift registers
    [CMPE2750.kicad_sch, Display.kicad_sch]
2024-11-09 Finished the display and input switch schematics. Also added input buffers to the inputs and made them differential
    [CMPE2750.kicad_sch, Display.kicad_sch, filters_and_amps.kicad_sch, switch_leds.kicad_sch]
2024-11-09 Changed some parts so it now only uses one type of op amp
    [filter_amps.kicad_sch, filters_and_amps.kicad_sch]
2024-11-11 Almost done. Just going to try and change something
    [CMPE2750.kicad_sch, Display.kicad_sch, filter_amps.kicad_sch, filters_and_amps.kicad_sch, power_supply.kicad_sch]
2024-11-11 Schematic is done?
    [CMPE2750.kicad_sch, Display.kicad_sch, filter_amps.kicad_sch, filters_and_amps.kicad_sch, power_supply.kicad_sch, switch_leds.kicad_sch, switches.kicad_sch]
2024-11-12 *Now* it's finished. Maybe.
    [CMPE2750.kicad_sch, Display.kicad_sch]
2024-11-12 Swapped the current limiting diodes for resistors. They *should* be good enough under normal operating conditions. Also added some pull-down resistors. Done?
    [CMPE2750.kicad_sch, Display.kicad_sch, filters_and_amps.kicad_sch, switch_leds.kicad_sch]
2024-11-12 Added mounting holes to the schematic, reset the annotations, updated a few footprints, and fixed some issues that were discovered on the ERC.
    [CMPE2750.kicad_sch, Display.kicad_sch, filter_amps.kicad_sch, filters_and_amps.kicad_sch, power_supply.kicad_sch, switch_leds.kicad_sch, switches.kicad_sch]
2024-11-12 Added a ferrite bead and removed a decoupling cap from another ferrite bead
    [CMPE2750.kicad_sch, Display.kicad_sch, filter_amps.kicad_sch, filters_and_amps.kicad_sch, power_supply.kicad_sch, switch_leds.kicad_sch, switches.kicad_sch]
2024-11-17 Component placing partly done. Saving before overwriting the pcb with the templating script output
    [CMPE2750.kicad_sch, CMPE2750_mod.kicad_pcb, Display.kicad_sch, filters_and_amps.kicad_sch, power_supply.kicad_sch, switch_leds.kicad_sch]
2024-11-17 Component placing done-ish
    [CMPE2750.kicad_pcb, CMPE2750_mod.kicad_pcb]
2024-11-19 pcb almost done, just need to do the final copper fill
    [CMPE2750.kicad_pcb, CMPE2750.kicad_sch, power_supply.kicad_sch]
2024-11-21 Made the final fills and the drill files
    [CMPE2750-B_Cu.gbr, CMPE2750-B_Mask.gbr, CMPE2750-B_Paste.gbr, CMPE2750-B_Silkscreen.gbr, CMPE2750-Edge_Cuts.gbr, CMPE2750-F_Cu.gbr, CMPE2750-F_Mask.gbr, CMPE2750-F_Paste.gbr]
2024-11-23 Finished and sent to JLCPCB
    [CMPE2750-B_Cu.gbr, CMPE2750-B_Mask.gbr, CMPE2750-B_Paste.gbr, CMPE2750-B_Silkscreen.gbr, CMPE2750-Edge_Cuts.gbr, CMPE2750-F_Cu.gbr, CMPE2750-F_Mask.gbr, CMPE2750-F_Paste.gbr]
